zbigos/powercore/powercore.png

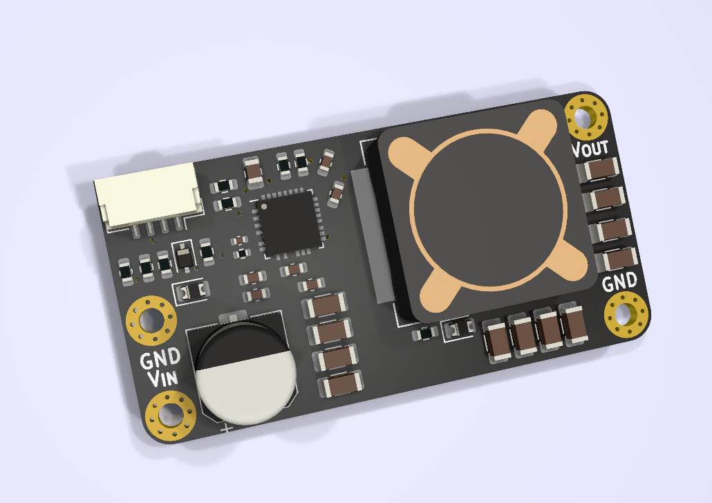
powercore.png
