zbigos/powercore/powercore.pdf

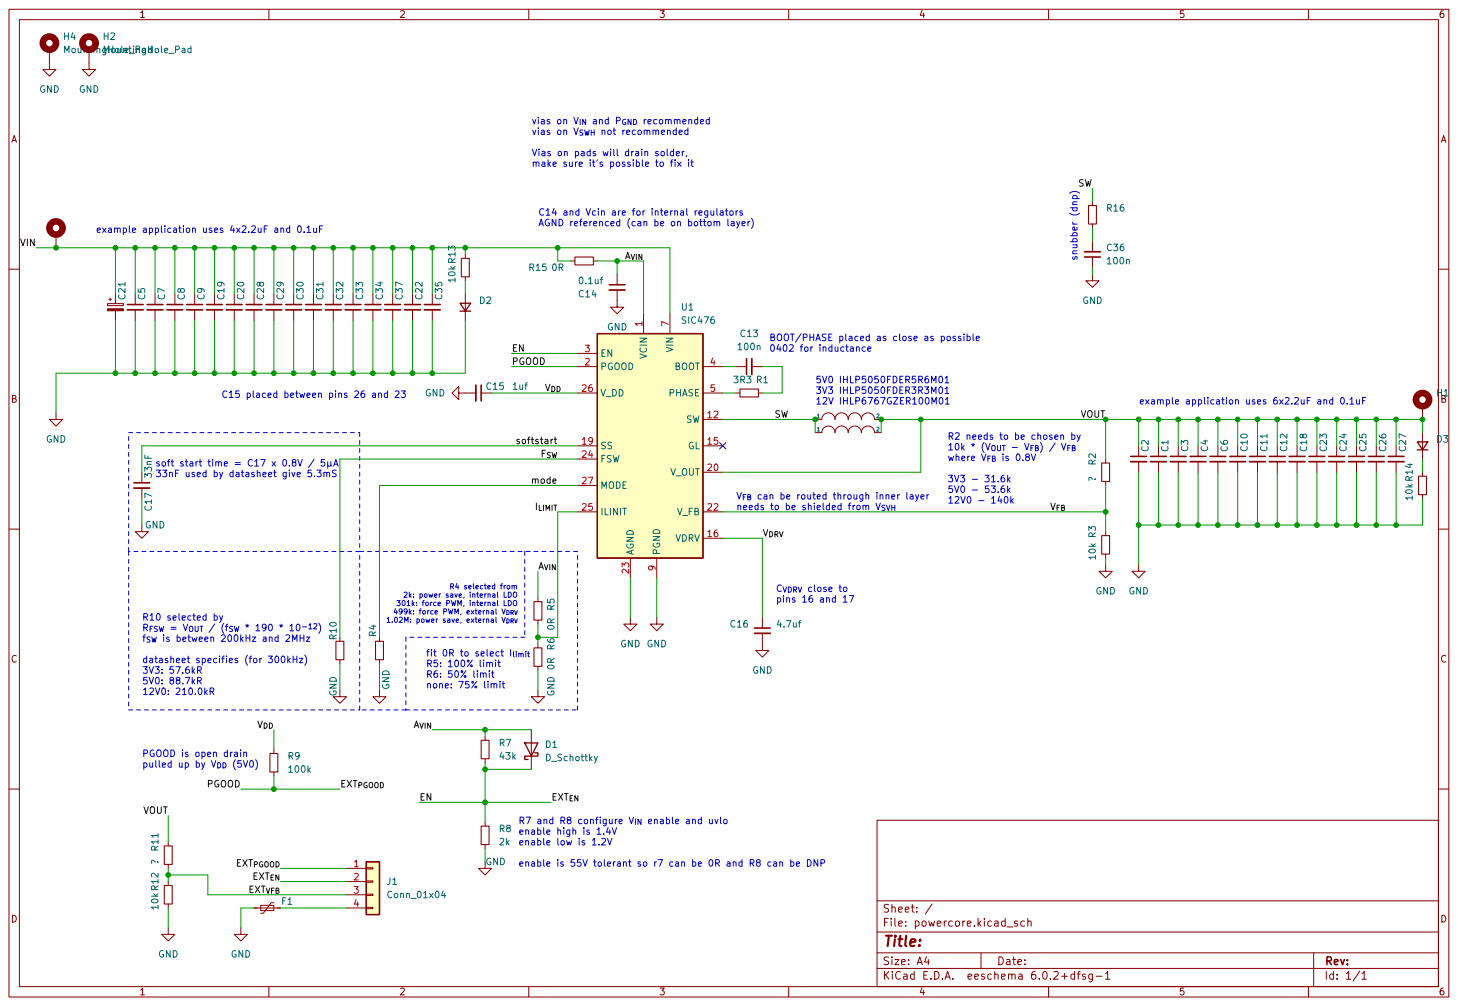
[picture p2: page 1]

vias on V_{IN} and P_{GND} recommended
vias on V_{SWH} not recommended

Vias on pads will drain solder,
make sure it's possible to fix it

C14 and Vcin are for internal regulators
AGND referenced (can be on bottom layer)

example application uses 4x2.2uF and 0.1uF

1 SW 12 GL 15 VDRV 16 SS 19 PGOOD 2 V_OUT 20 V_FB 22 AGND 23 FSW 24

0402 for inductance PGOOD is open drain

fit 0R to select I_{limit} R5: 100% limit R6: 50% limit none: 75% limit C15 placed between pins 26 and 23

example application uses 6x2.2uF and 0.1uF

R2 needs to be chosen by
10k * (V_{OUT} - V_{FB}) / V_{FB}
where V_{FB} is 0.8V

33nF used by datasheet give 5.3mS

V_{FB} can be routed through inner layer
needs to be shielded from V_{SVH}

I_{LIMIT}

2k: power save, internal LDO 301k: force PWM, internal LDO

R10 selected by
R_{FSW} = V_{OUT} / (f_{SW} * 190 * 10^{-12})
f_{SW} is between 200kHz and 2MHz

pulled up by V_{DD} (5V0)
