zbigos/powercore/powercore.kicad_pcb

## KiCad design powercore.kicad_pcb (2022-05-29)

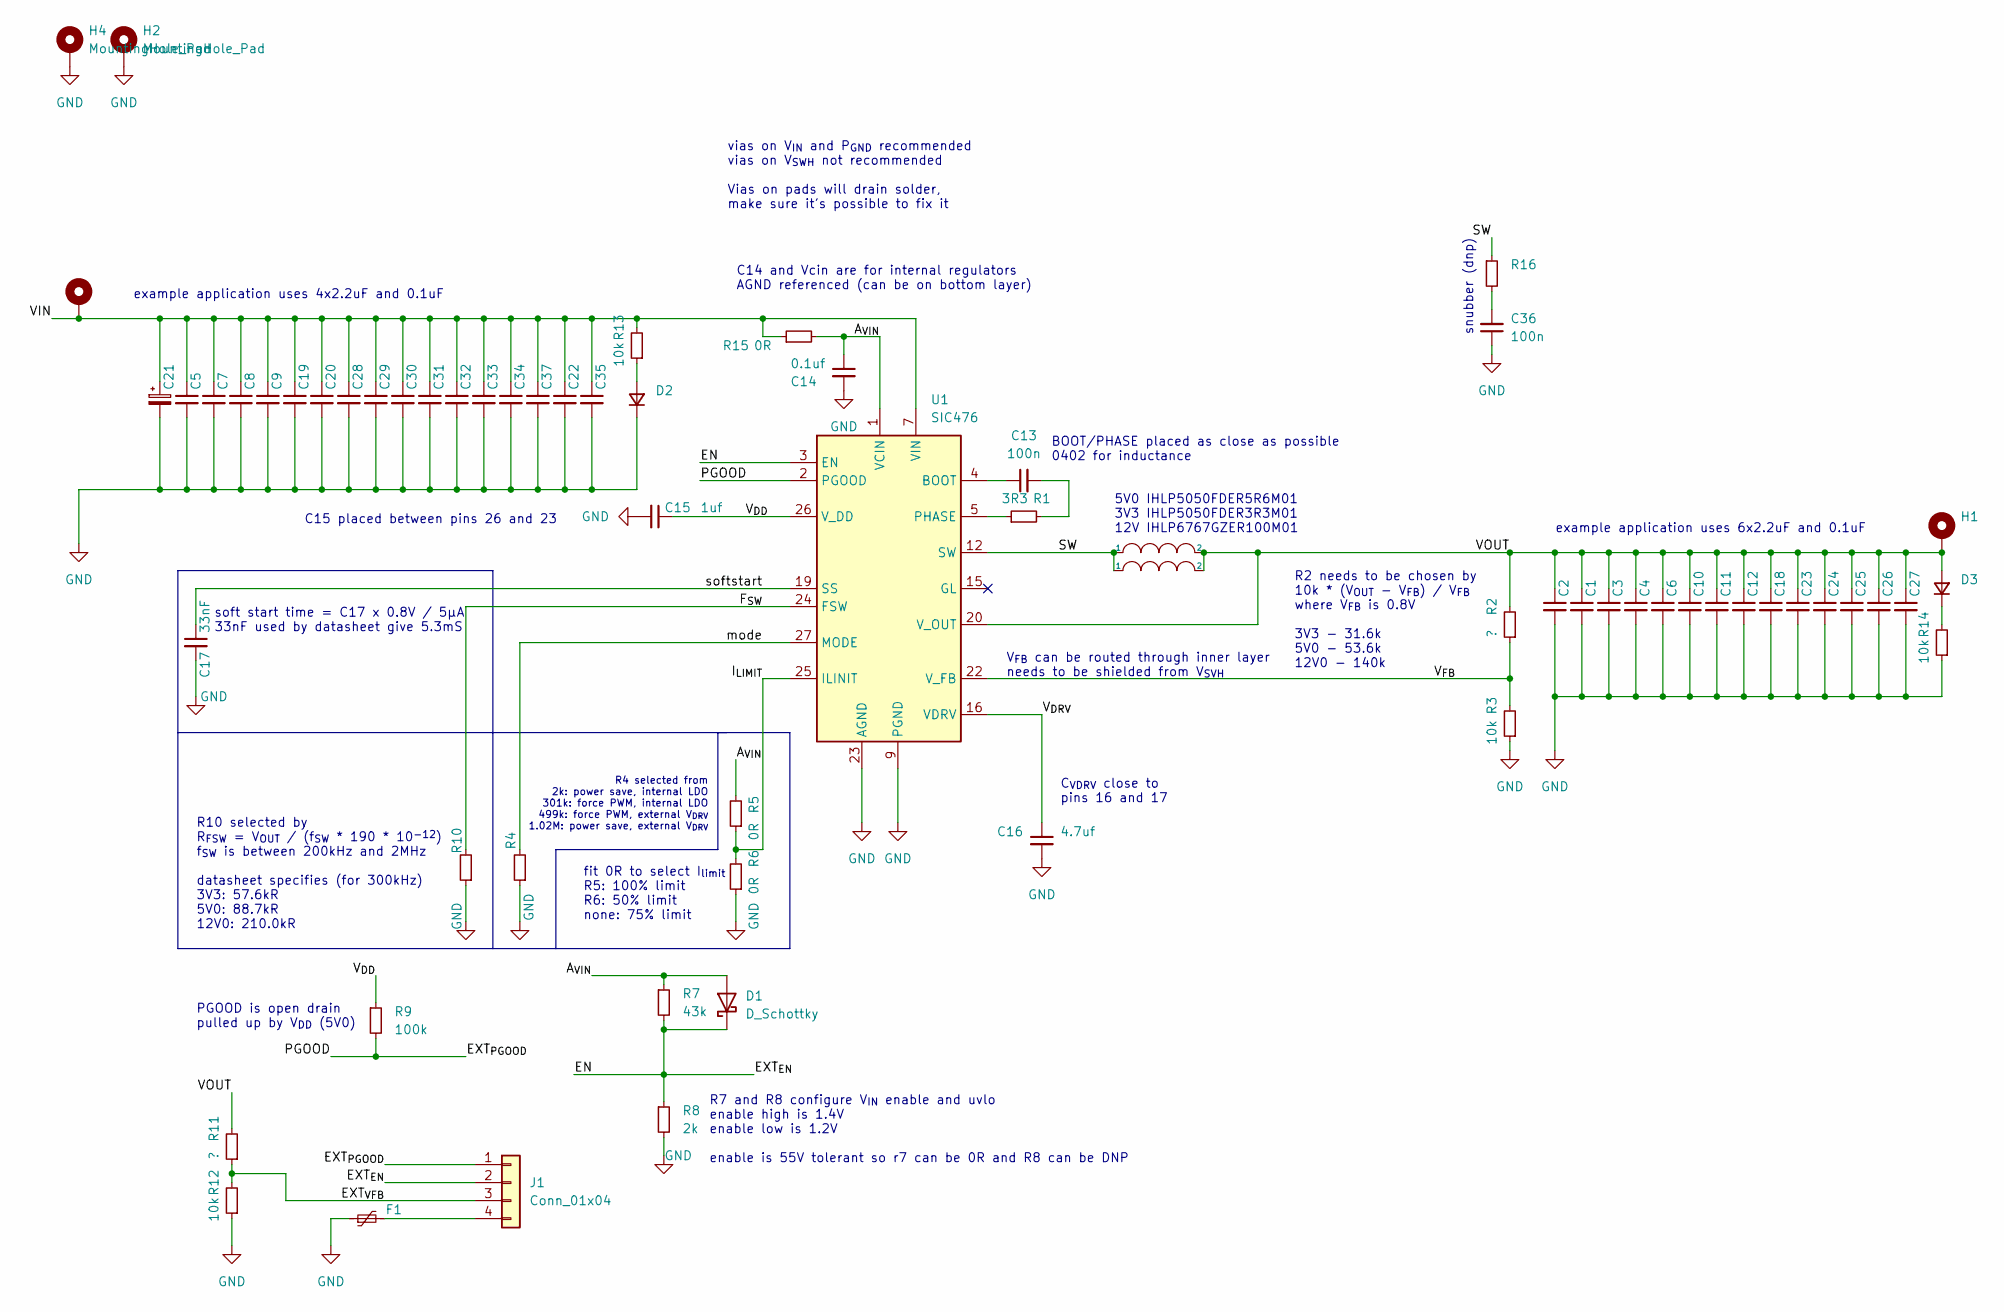
[picture p3: schematic powercore.kicad_sch]

Parts:
C1, C2, C3, C4, C5, C6, C7, C8, C9, C10, C11, C12, C18, C20, C28, C29: C_Small; C_1206_3216Metric
C13: 100n; C_0402_1005Metric
C14: 0.1uf; C_0603_1608Metric
C15: 1uf; C_0805_2012Metric
C16: 4.7uf; C_0603_1608Metric
C17: 33nF; C_0603_1608Metric
C19, C22, C35, C37: C_Small; C_0603_1608Metric
C21: C_Polarized_Small; CP_Elec_8x10
C23, C24, C25, C26, C27, C30, C31, C32, C33, C34: C_Small; C_1210_3225Metric
C36: 100n; C_0603_1608Metric
D1: D_Schottky; D_SOD-323
D2, D3: D_Small; D_0805_2012Metric
F1: Polyfuse_Small; Fuse_0603_1608Metric
H1, H2, H3, H4: MountingHole_Pad; MountingHole_2.2mm_M2_Pad_Via
J1: Conn_01x04; JST_GH_SM04B-GHS-TB_1x04-1MP_P1.25mm_Horizontal
L1: INDUCTOR; L_Vishay_IHLP-6767
L2: INDUCTOR; L_Vishay_IHLP-5050
R1: 3R3; R_0402_1005Metric
R2, R4, R10, R11: ?; R_0603_1608Metric
R3, R12, R13, R14: 10k; R_0603_1608Metric
R5, R6, R15: 0R; R_0603_1608Metric
R7: 43k; R_0603_1608Metric
R8: 2k; R_0603_1608Metric
R9: 100k; R_0603_1608Metric
R16: R_Small; R_0603_1608Metric
U1: SIC476; Vishay_PowerPAK_MLP55-27L

Connections:
/A_{VIN}: C14.1, D1.2 (A), R5.2, R7.1, R15.2, U1.1 (VCIN)
/EN: D1.1 (K), J1.2, R7.2, R8.1, U1.3 (EN)
/EXT_{PGOOD}: J1.1, R9.2, U1.2 (PGOOD)
/EXT_{VFB}: J1.3, R11.1, R12.2
/F_{SW}: R10.2, U1.24 (FSW)
/I_{LIMIT}: R5.1, R6.2, U1.25 (ILINIT)
/SW: L1.1, L2.1, R16.1, U1.12 (SW), U1.13 (SW), U1.14 (SW)
/VIN: C5.1, C7.1, C8.1, C9.1, C19.1, C20.1, C21.1, C22.1, C28.1, C29.1, C30.1, C31.1, C32.1, C33.1, C34.1, C35.1, C37.1, H3.1, R13.2, R15.1, U1.7 (VIN), U1.8 (VIN), U1.29 (VIN)
/VOUT: C1.1, C2.1, C3.1, C4.1, C6.1, C10.1, C11.1, C12.1, C18.1, C23.1, C24.1, C25.1, C26.1, C27.1, D3.2 (A), H1.1, L1.2, L2.2, R2.2, R11.2, U1.20 (V_OUT)
/V_{DD}: C15.1, R9.1, U1.26 (V_DD)
/V_{DRV}: C16.1, U1.16 (VDRV)
/V_{FB}: R2.1, R3.2, U1.22 (V_FB)
/mode: R4.2, U1.27 (MODE)
/softstart: C17.1, U1.19 (SS)
GND: C1.2, C2.2, C3.2, C4.2, C5.2, C6.2, C7.2, C8.2, C9.2, C10.2, C11.2, C12.2, C14.2, C15.2, C16.2, C17.2, C18.2, C19.2, C20.2, C21.2, C22.2, C23.2, C24.2, C25.2, C26.2, C27.2, C28.2, C29.2, C30.2, C31.2, C32.2, C33.2, C34.2, C35.2, C36.1, C37.2, D2.1 (K), F1.1, H2.1, H4.1, R3.1, R4.1, R6.1, R8.2, R10.1, R12.1, R14.1, U1.9 (PGND), U1.10 (PGND), U1.11 (PGND), U1.17 (PGND), U1.23 (AGND), U1.28 (AGND), U1.30 (PGND)
unnamed: C13.1, U1.4 (BOOT)
unnamed: C13.2, R1.2
unnamed: C36.2, R16.2
unnamed: D2.2 (A), R13.1
unnamed: D3.1 (K), R14.2
unnamed: F1.2, J1.4
unnamed: R1.1, U1.5 (PHASE), U1.6 (PHASE)

Notes on the sheet:
R4 selected from 2k: power save, internal LDO 301k: force PWM, internal LDO 499k: force PWM, external V_{DRV} 1.02M: power save, external V_{DRV}
C_{VDRV} close to pins 16 and 17
C14 and Vcin are for internal regulators AGND referenced (can be on bottom layer)
vias on V_{IN} and P_{GND} recommended vias on V_{SWH} not recommended Vias on pads will drain solder, make sure it's possible to fix it
example application uses 6x2.2uF and 0.1uF
5V0 IHLP5050FDER5R6M01 3V3 IHLP5050FDER3R3M01 12V IHLP6767GZER100M01
PGOOD is open drain pulled up by V_{DD} (5V0)
soft start time = C17 x 0.8V / 5μA 33nF used by datasheet give 5.3mS
R7 and R8 configure V_{IN} enable and uvlo enable high is 1.4V enable low is 1.2V enable is 55V tolerant so r7 can be 0R and R8 can be DNP
C15 placed between pins 26 and 23
fit 0R to select I_{limit} R5: 100% limit R6: 50% limit none: 75% limit
R2 needs to be chosen by 10k * (V_{OUT} - V_{FB}) / V_{FB} where V_{FB} is 0.8V 3V3 - 31.6k 5V0 - 53.6k 12V0 - 140k
V_{FB} can be routed through inner layer needs to be shielded from V_{SVH}
snubber (dnp)
example application uses 4x2.2uF and 0.1uF
BOOT/PHASE placed as close as possible 0402 for inductance
R10 selected by R_{FSW} = V_{OUT} / (f_{SW} * 190 * 10^{-12}) f_{SW} is between 200kHz and 2MHz datasheet specifies (for 300kHz) 3V3: 57.6kR 5V0: 88.7kR 12V0: 210.0kR

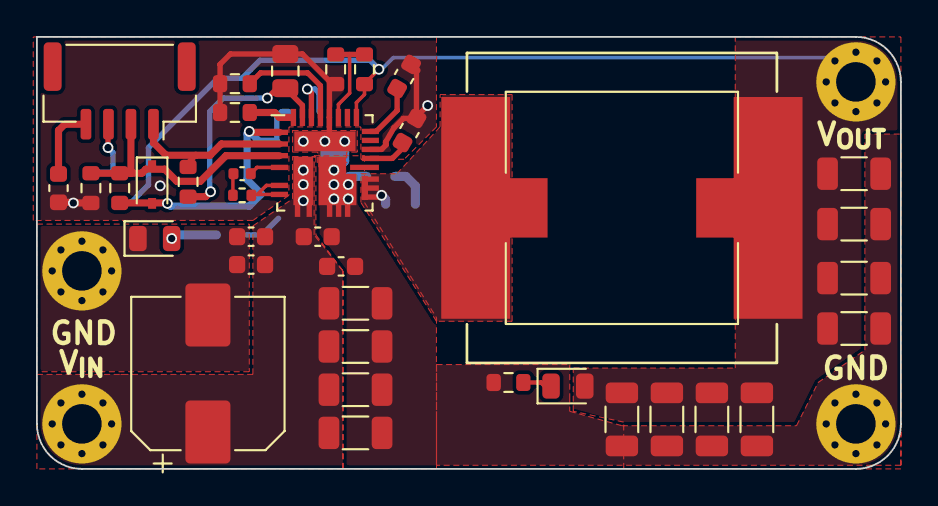
[picture p4: board powercore.kicad_pcb from above]

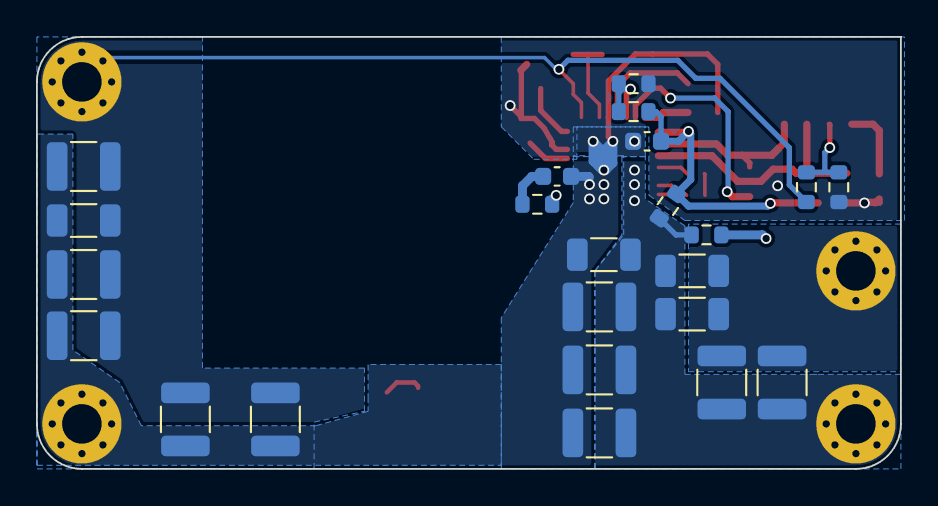
[picture p5: board powercore.kicad_pcb from below]

Board: 4 copper layers, 48.0 x 24.0 mm, 65 parts (23 on the bottom side), 22 nets.
